agustin58ruiz/DISE-O_CIRCUITOS_ELECTRONICOS_1C_2022/Imagenes/PARTES DEL CIRCUITO.png

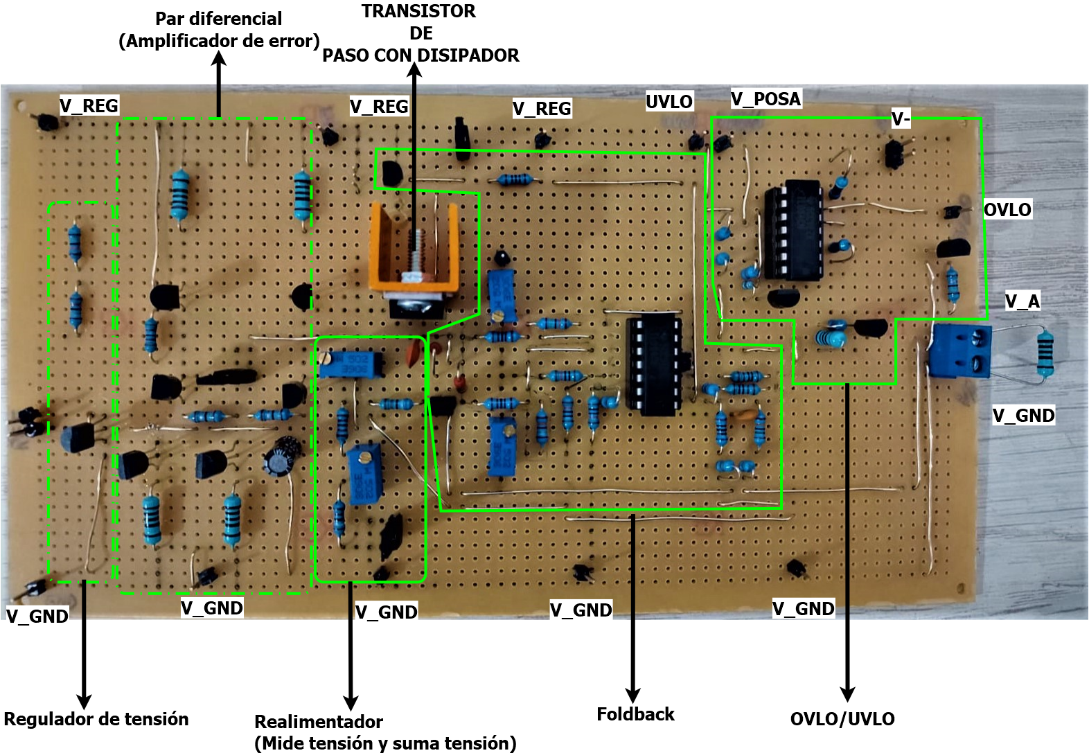
Imagenes/PARTES DEL CIRCUITO.png
