agustin58ruiz/DISE-O_CIRCUITOS_ELECTRONICOS_1C_2022/Eficiencia.png

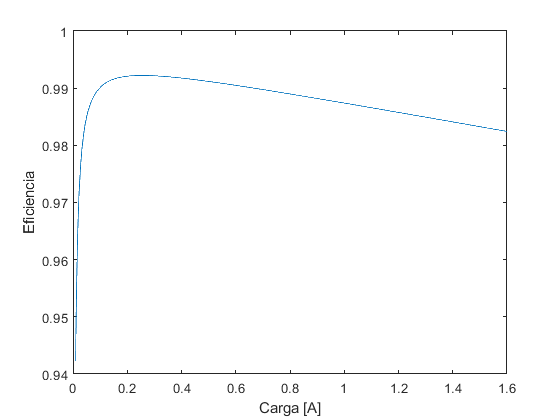
Eficiencia.png
