agustin58ruiz/DISE-O_CIRCUITOS_ELECTRONICOS_1C_2022/reg_de_linea_10us_buck.PNG

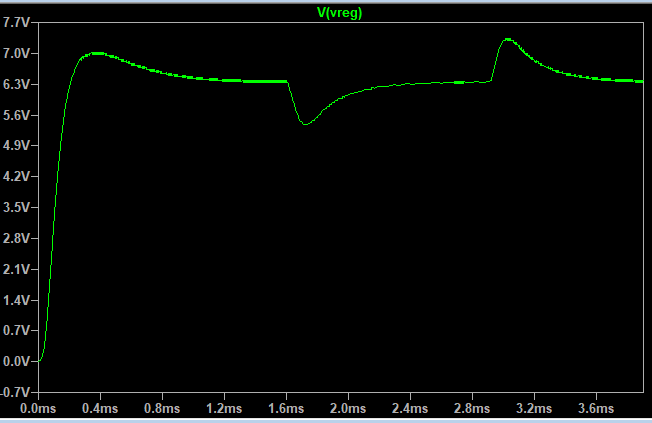
reg_de_linea_10us_buck.PNG
