agustin58ruiz/DISE-O_CIRCUITOS_ELECTRONICOS_1C_2022/resp_en_frec_buck.PNG

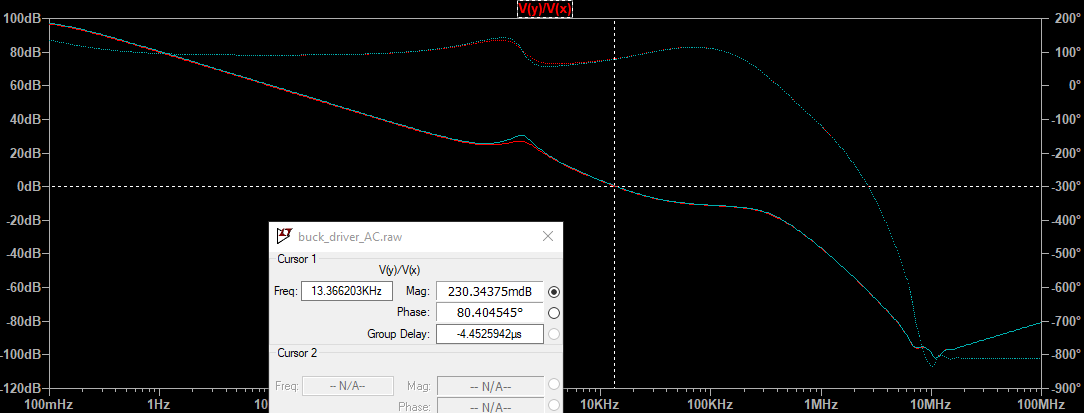
resp_en_frec_buck.PNG
