agustin58ruiz/DISE-O_CIRCUITOS_ELECTRONICOS_1C_2022/BUCK_tran_carga_dinamica.asc

A1: varistor; 60
C2: cap; 270n
C3: cap; .15µ; IC=0
R1: res; 63.5
R2: res; 1µ
R3: res; 1k
R4: res; 3.25
U2: LT1215
V1: voltage; 7; Rser=100m
V2: voltage; -5; Rser=100m
V3: voltage; 36
V4: voltage; PULSE(0 0 1.6m 10u 10u 1.3m)
V6: voltage; 12
V7: voltage; 1.2; Rser=1
V9: voltage; PWL(0 0 1.6m 0 1.61m 10 2m 10 2.01m 0 2.4m 0 2.401m 10 3m 10 3.01m 0 4m 0)
X3: buck
Named nets: 0, V-, VDD, VCC, Vin, VREG, Vref
;.step param RLOAD list 3.7 60
Support
Simulación
Parametros
Carga BUCK
.options gmin=1e-10
.options abstol=1e-10
.options reltol=0.0005
.options cshunt=1e-15
.tran 0 4m 0 startup
Ref1
