agustin58ruiz/DISE-O_CIRCUITOS_ELECTRONICOS_1C_2022/BUCK_tran_linea_dinamica_10us.asc

C2: cap; 270n
C3: cap; .15µ; IC=0
R1: res; 3.7
R3: res; 1k
U2: LT1215
V1: voltage; 7; Rser=100m
V2: voltage; -5; Rser=100m
V3: voltage; 36
V4: voltage; PULSE(0 -24 1.6m 10u 10u 1.3m)
V6: voltage; 12
V7: voltage; 1.2; Rser=1
X3: buck
Named nets: 0, V-, VDD, VCC, Vin, VREG, Vref
;.step param RLOAD list 3.7 60
Support
Simulación
Parametros
Carga BUCK
.options gmin=1e-10
.options abstol=1e-10
.options reltol=0.0005
.options cshunt=1e-15
.tran 0 4m 0 startup
Ref1
