agustin58ruiz/DISE-O_CIRCUITOS_ELECTRONICOS_1C_2022/buck.asc

C1: cap; 454p
C2: cap; 1n
C3: cap; 270n
C4: cap; 3.3n
C5: cap; 1n
C6: cap; {C}; Rser=100m
C7: cap; 0.01µ
C8: cap; 120p
C9: cap; 200p
C10: cap; 200p
C11: cap; 1n; Rser=1m
C12: cap; 100p
C13: cap; 10n
C14: cap; 3.3n
C15: cap; 10n
D1: diode; 1N4148
D2: diode; 1N4007
D3: diode; 1N4148
D4: diode; 1N4007
D5: diode; 1N4007
L1: ind; 7.5n
L2: ind; 7.5n
L3: ind; 4.5n
L4: ind; {L}
L5: ind; 4.5n
M1: nmos; NDC7002N
M2: pmos; Si1013
R1: res; 400
R2: res; 10.9k
R3: res; 110k
R4: res; 400
R5: res; 99k
R6: res; 1k
R7: res; 100k
R8: res; 3.3k
R9: res; 120k
R10: res; 10
R11: res; 1
R12: res; 1
R13: res; 10k
R14: res; 42.9k
R15: res; 10
R16: res; 100
R17: res; 100
R18: res; 1k
R19: res; 5k
U1: IR2110
U2: TL081
U3: TL081
U4: irf520
U5: NE555
U6: irf520
U7: LT1215
U8: LT1720
X1: NAND
X2: NAND
X5: NOT
X7: NOT
X8: NOT
X9: NOT
Named nets: HO2, LO2, HIN, LIN, Vsaw, Vcua, V-, Vref, GND, VDD, VCC, Vin, VREG, Verr
.param C 100u
.param L 65.3u
.include irf520.txt
.include IR2110.txt
.MODEL 1N4007 D  ( IS=76.9p RS=42.0m BV=1.00k IBV=5.00u
+ CJO=26.5p  M=0.333 N=1.45 TT=4.32u )
Generacion del diente de sierra
Comparador con diente de sierra
Driver
Error amp
f
Puertos
Generador de dead-time
Parametros
Modelos
Librerías
