agustin58ruiz/DISE-O_CIRCUITOS_ELECTRONICOS_1C_2022/uvlo_problematico.asc

M1: nmos; 2N7000
R1: res; 120k
R2: res; 30k
R3: res; 750k
UVLO1: LT1721
V1: voltage; 1.2
V2: voltage; 5
V3: voltage; PWL(0 0 0.2m 8 0.3m 5.63 1m 5.93)
V4: voltage; SINE(0 20m 200k)
Named nets: 0, Vdd, Vref2, Vo, uvlo, vdd
UVLO
Fall: 5.6V
Rise: 5.9V
.tran 0 1m 0
.model 2N7000 VDMOS(Rg=3 Vto=3 Rd=0 Rs=.75 Rb=.14 Kp=.17 mtriode=1.25 Cgdmax=80p Cgdmin=12p Cgs=50p Cjo=50p Is=.04p mfg=Fairchild Vds=60 Ron=5 Qg=.223n)
