agustin58ruiz/DISE-O_CIRCUITOS_ELECTRONICOS_1C_2022/buck_driver_lazo_abierto.asc

A1: srflop; 15
C1: cap; {Csnub}
C2: cap; {Csnub}
C3: cap; 270n
C4: cap; 270n
C5: cap; 3.3n
C6: cap; {CLOAD}; Rser=100m
C7: cap; 3.3n
C8: cap; 10n
C11: cap; 1n; Rser=1m
CurrMax1: LT1721
D1: diode; 1N4007
D2: diode; 1N4007
D3: diode; 1N4007
E1: e; 15
E2: e; 15
L1: ind; 7.5n
L2: ind; 4.5n
L3: ind; 7.5n
L4: ind; {L}
L5: ind; 4.5n
M2: nmos; 2N7000
OVLO1: LT1721
R1: res; 10
R2: res; 10
R3: res; 120k
R4: res; 4.99k
R5: res; 1k
R6: res; 30k
R7: res; 250
R8: res; 750k
R9: res; 60k
R10: res; {RLOAD}
R11: res; 1
R12: res; 1
R13: res; 60k
R14: res; 10k
R15: res; 10k
Rsens1: res; 0.1
U1: IR2110
U2: LT1215
U3: irf520
U6: irf520
UVLO1: LT1721
V1: voltage; 7
V2: voltage; PULSE(7 0 0 1n 1n 0.8939u 5u)
V3: voltage; PULSE(0 7 10n 1n 1n 0.8699u 5u)
V4: voltage; PWL(1n 0 20u 36 120u 46 150u 24)
V5: voltage; 5
V6: voltage; 1.2
V13: voltage; 15
X1: OR
Named nets: 0, LO2, HO2, HIN, LIN, V+, VO, VS, Vdd, Vref, Vo, uvlo, ovlo, OCP, sens+, sens-, Q, Qnot
.tran 0 150u 0 startup
.param CLOAD 1u
.param RLOAD=6
.param L 65.3u
.include irf520.txt
.include IR2110.txt
.MODEL 1N4007 D  ( IS=76.9p RS=42.0m BV=1.00k IBV=5.00u
+ CJO=26.5p  M=0.333 N=1.45 TT=4.32u )
.options gmin=1e-10
.options abstol=1e-10
.options reltol=0.0005
.options cshunt=1e-15
Driver
.param Csnub 10n
OVLO
Rise: 7.2V
UVLO
Fall: 5.6V
Rise: 5.9V
f = IoMax / Vref
A = f / Rsens
OCP
.model 2N7000 VDMOS(Rg=3 Vto=3 Rd=0 Rs=.75 Rb=.14 Kp=.17 mtriode=1.25 Cgdmax=80p Cgdmin=12p Cgs=50p Cjo=50p Is=.04p mfg=Fairchild Vds=60 Ron=5 Qg=.223n)
trig: 2A
Latch
