agustin58ruiz/DISE-O_CIRCUITOS_ELECTRONICOS_1C_2022/buck_driver_AC.asc

B2: bv; V=delay(v(ctrl)/5.75, 190ns)
C1: cap; 100p
C2: cap; 1n
C3: cap; 1n; Rser=5m
C5: cap; 1n
C6: cap; {CLOAD}; Rser=100m
L4: ind; {L}
R1: res; 100
R2: res; 1k
R3: res; 5k
R7: res; 100k
R8: res; 10k
R9: res; 100k
R10: res; {RLOAD}
R13: res; 10k
R14: res; 42.9k
U1: ccm2; Ron=0.23
U2: TL081
U3: TL081
V1: voltage; PULSE(0 -24 1m 10u 10u 1m)
V2: voltage; 1.2
V10: voltage; 36
Vg1: voltage; 7; AC 1
Vg2: voltage; 5; AC 1
Vz1: voltage; ""; AC 1
Named nets: 0, VO, VPOS, Verr, ctrl, x, y, VPOS-
;tran 0 3m 0 startup
.param CLOAD 100u
.step param RLOAD list 3.7 61
.param L 65.3u
.include irf520.txt
.include IR2110.txt
.MODEL 1N4007 D  ( IS=76.9p RS=42.0m BV=1.00k IBV=5.00u
+ CJO=26.5p  M=0.333 N=1.45 TT=4.32u )
.options gmin=1e-10
.options abstol=1e-10
.options reltol=0.003
.options cshunt=1e-15
Error amp
f
.include average.lib
.ac dec 100 .1 100meg
