agustin58ruiz/DISE-O_CIRCUITOS_ELECTRONICOS_1C_2022/dead_time.asc

C1: cap; 200p
C2: cap; 200p
M1: nmos; NDC7002N
M2: pmos; Si1013
V1: voltage; PULSE(0 7 0 80n 80n 0.8u 5u)
Vg1: voltage; 7; AC 1; Rser=100m
X1: NAND
X2: NAND
X5: NOT
X6: NOT
X7: NOT
X8: NOT
Named nets: VPOS, 0, LIN, HIN
Inversor
.tran 0 1m 0
