agustin58ruiz/DISE-O_CIRCUITOS_ELECTRONICOS_1C_2022/BUCK_LDO_tran.asc

C1: cap; {CLOAD}
C2: cap; 270n
C3: cap; {CLOAD}
R1: res; 3.6k
R2: res; 5k
R3: res; 5k
R4: res; R=v(VAR)
R17: res; R=v(VAR)
R18: res; 10
SEL1: voltage; PWL(500m 5 501m 0 1 0)
U1: LT1009
V1: voltage; 7
V2: voltage; -5
V3: voltage; PWL(25m 5 75m 250 250m 250 270m 0.01 350m 0.01 400m 15 475m 15 500m 5 525m 5 575m 250 750m 250 770m 0.01 850m 0.01 900m 15 975m 15 1 5)
V4: voltage; PWL(125m 5 126m 0 150m 0 175m 5 625m 5 626m 0 650m 0 675m 5)
V5: voltage; 5
V6: voltage; 15
V7: voltage; 36
Vref1: voltage; 1.2
X1: LDOA
X2: LDOB
X3: buck
Named nets: 0, V-, VAR, VREG, S, E, Vposa, Vref, VDD, VCC, Vin
.op
.param CLOAD 15u
.tran 0 1 0 .00005
Enable
Carga
Carga LDOB
Ref1
Ref2
Support
Simulación
Parametros
Selección usuario
Carga
Carga LDOA
