agustin58ruiz/DISE-O_CIRCUITOS_ELECTRONICOS_1C_2022/LDOA_foldback.asc

C1: cap; 100n
C2: cap; {CLOAD}
C4: cap; 22n
M1: pmos; BS250P
M3: nmos; 2N7000
Q1: npn; BC547C
Q2: npn; BC547C
Q3: npn; BC547C
Q4: npn; BC547C
Q5: pnp; BC557C
Q6: pnp; BC557C
R1: res; 11k
R2: res; 100
R3: res; 11k
R4: res; 5.36k
R5: res; 100
R6: res; 10
R7: res; 243k
R8: res; 100
R10: res; 100
R11: res; 24.9
R12: res; 49.9
R19: res; 665
R20: res; 2.21k
R21: res; 1.82k
R28: res; 6.98k
R29: res; 243k
R30: res; 4.02k
R31: res; 6.98k
R32: res; 100k
R33: res; 100k
R34: res; 100k
R35: res; 100k
R36: res; 1k
R37: res; 1k
R38: res; 150k
R39: res; 150k
RL: res; {RLOAD}
Rs1: res; .1
SEL1: voltage; 5
U1: irf9520
U2: TL081
U3: TL081
U5: TL081
V1: voltage; 0
V2: voltage; -5
Vref: voltage; 1.2
VREG: voltage; 6.35
Named nets: 0, Va, Vref, Vo, Vi, va, VREG, Vact, Vs, Vsens, Vref2, Vf, V-
Referencia
Realimentador
a
Transistor de paso
Carga
.step param RLOAD .01 15 .04
.op
Buck
.inc sihf9520.txt
.model 2N7000 VDMOS(Rg=3 Vto=3 Rd=0 Rs=.75 Rb=.14 Kp=.17 mtriode=1.25 Cgdmax=80p Cgdmin=12p Cgs=50p Cjo=50p Is=.04p mfg=Fairchild Vds=60 Ron=5 Qg=.223n)
Actuador
Amplificador de Error
.param CLOAD 15u
Sumador
Sensado de Corriente
.MODEL BS250P VDMOS pchan Rg=160 VTO=-3.193 RS=2.041 RD=0.697 IS=2E-13 KP=0.277 Cjo=105p LAMBDA=1.2E-2 RB=0.309 Rds=1.2E8 Cgdmax=57p Cgdmin=5p CGS=47p TT=86.56n BV=45 IBV=10u
