agustin58ruiz/DISE-O_CIRCUITOS_ELECTRONICOS_1C_2022/LDOA_mc.asc

C1: cap; {mc(100n,tolc)}
C2: cap; {mc(22n,tolc)}
C3: cap; {CLOAD}
M1: pmos; BS250P
M2: nmos; 2N7000
M3: pmos; BS250P
M4: nmos; 2N7000
M5: nmos; 2N7000
M6: pmos; BS250P
Q1: npn; BC547C
Q2: npn; BC547C
Q3: npn; BC547C
Q4: npn; BC547C
Q5: pnp; BC557C
Q6: pnp; BC557C
R1: res; {mc(665,tolr)}
R2: res; {mc(2.21k,tolr)}
R3: res; {mc(1.82k,tolr)}
R4: res; {mc(6.98k,tolr)}
R5: res; {mc(11k,tolr)}
R6: res; {mc(11k,tolr)}
R7: res; {mc(243k,tolr)}
R8: res; {mc(243k,tolr)}
R9: res; {mc(4.02k,tolr)}
R10: res; {mc(6.98k,tolr)}
R11: res; {mc(100k,tolr)}
R12: res; {mc(100k,tolr)}
R13: res; {mc(100k,tolr)}
R14: res; {mc(100k,tolr)}
R15: res; {mc(1k,tolr)}
R16: res; {mc(1k,tolr)}
R17: res; {mc(150k,tolr)}
R18: res; {mc(150k,tolr)}
R19: res; {mc(100,tolr)}
R20: res; {mc(5.36k,tolr)}
R21: res; {mc(100,tolr)}
R22: res; {mc(100,tolr)}
R23: res; {mc(100,tolr)}
R24: res; {mc(24.9,tolr)}
R25: res; {mc(24.9,tolr)}
R26: res; {mc(40.2k,tolr)}
R27: res; {mc(250k,tolr)}
R28: res; {mc(60.4k,tolr)}
R29: res; {mc(9.76k,tolr)}
R30: res; {mc(9.09k,tolr)}
R31: res; {mc(0.715k,tolr)}
R32: res; 10
R33: res; 3.6k
R34: res; 5k
R35: res; 5k
R36: res; 25.5
RLOAD: res; R=v(VAR)
Rs1: res; {mc(.1,tolr)}
SEL1: voltage; PWL(500m 5 501m 0 1 0)
U1: irf9520
U2: TL081
U3: TL081
U4: TL081
U5: TL081
U6: TL081
U7: LT1009
V1: voltage; -6.35
V2: voltage; PWL(125m 5 126m 0 150m 0 175m 5 625m 5 626m 0 650m 0 675m 5)
V3: voltage; 5
V4: voltage; PWL(25m 7 75m 250 250m 250 320m 0.01 350m 0.01 400m 7 401m 7 401.000000001m 1G 402m 1G 403m 15 475m 15 500m 10 525m 10 575m 250 600m 250 700m 250 701m 10 702m 10 703m 1G 704m 250 710m 250 900m 0.01 925m 0.01 950m 15 975m 15 1 10 702.000001 1G)
Vref1: voltage; 1.2
VREG1: voltage; PULSE(0 6.35 .00001 .00001 .00001 1)
Named nets: VREG, Vact, Vsens, Vref2, Vref, Vf, 0, V-, ENLDOA, VA, SELA, GND, VPOSA, Vposa, UVLO_OUT, OVLO_OUT, VAR, S, ovlo, uvlo
.param RLOAD 100
.inc sihf9520.txt
.model 2N7000 VDMOS(Rg=3 Vto=3 Rd=0 Rs=.75 Rb=.14 Kp=.17 mtriode=1.25 Cgdmax=80p Cgdmin=12p Cgs=50p Cjo=50p Is=.04p mfg=Fairchild Vds=60 Ron=5 Qg=.223n)
.param CLOAD 15u
Referencias
Amplificador de error
Enable
Actuador
Transistor
de paso
Realimentador
Sensado de corriente
Sumador
Amplificador
de error
Modelos
Parámetros
Librerías
Foldback
Foldback
UVLO
OVLO
Mediciones MC
.step param x 0 999 1 ; a dummy parameter to cycle Monte Carlo Runs
.meas TRAN Tensión5V AVG V(VA) FROM 30m TO 35m
.param tolr=0.01 ;+/-1% tolerancia de la resistencia
.param tolc=0.2 ;+/-20% tolerancia del capacitor
Tolerancias MC
Simulación
.option noopiter
.tran 0 1 0 .00005
Enable
Ref1
Ref2
Support
Buck
Carga
Carga
Selección usuario
.meas TRAN Tensión3.3V AVG V(VA) FROM 530m TO 535m
.meas TRAN CorrienteFoldback AVG I(RLOAD) FROM 325m TO 340m
.meas TRAN CorrienteMax MAX I(RLOAD) FROM 318m TO 319m
.meas TRAN StartupTime FIND time WHEN V(va)=4.9
.MODEL BS250P VDMOS pchan Rg=160 VTO=-3.193 RS=2.041 RD=0.697 IS=2E-13 KP=0.277 Cjo=105p LAMBDA=1.2E-2 RB=0.309 Rds=1.2E8 Cgdmax=57p Cgdmin=5p CGS=47p TT=86.56n BV=45 IBV=10u
.meas TRAN VA_UVLO_5V(rising) AVG V(uvlo) from 905m to 918m
.meas TRAN VA_UVLO_3V(rising) AVG V(uvlo) from 72m to 96m
.meas TRAN VA_UVLO_3V(falling) AVG (V(uvlo)*V(va)/V(vf)) from 40ms to 50ms
.meas TRAN F5 AVG (V(va)/V(vf)) from 800ms to 810ms
.meas TRAN F3 AVG (V(va)/V(vf)) from 40ms to 50ms
.meas TRAN VA_UVLO_5V(falling) AVG (V(uvlo)*V(va)/V(vf)) from 800ms to 810ms
.meas TRAN VA_OVLO_3V(rising) AVG (V(ovlo)*V(va)/V(vf)) from 701.6ms to 701.8ms
.meas TRAN VA_OVLO_3V(falling) AVG (V(ovlo)*V(va)/V(vf)) from 702.4ms to 703.6ms
.meas TRAN VA_OVLO_5V(rising) AVG (V(ovlo)*V(va)/V(vf)) from 380ms to 400ms
.meas TRAN VA_OVLO_5V(falling) AVG (V(ovlo)*V(va)/V(vf)) from 401.4ms to 402.6ms
