agustin58ruiz/DISE-O_CIRCUITOS_ELECTRONICOS_1C_2022/LDOA_with_OVLO.asc

C1: cap; 100n
C4: cap; 22n
M1: pmos; FDC5614P
M2: pmos; FDC5614P
M3: nmos; 2N7000
M4: nmos; 2N7000
M5: nmos; BSP89
M6: nmos; 2N7000
Q1: npn; BC547C
Q2: npn; BC547C
Q3: npn; BC547C
Q4: npn; BC547C
Q5: pnp; BC557C
Q6: pnp; BC557C
R1: res; 11k
R2: res; 100
R3: res; 11k
R4: res; 5.36k
R5: res; 100
R6: res; 70k
R7: res; 243k
R8: res; 100
R9: res; 50k
R10: res; 100
R11: res; 24.9
R12: res; 49.9
R19: res; 665
R20: res; 2.21k
R21: res; 1.82k
R28: res; 6.98k
R29: res; 243k
R30: res; 4.02k
R31: res; 6.98k
R32: res; 100k
R33: res; 100k
R34: res; 100k
R35: res; 100k
R36: res; 1k
R37: res; 1k
R38: res; 150k
R39: res; 150k
RB1: res; 1.13k
RB: res; 4.99k
RH1: res; 25k
RH: res; 4.99k
Rs1: res; .1
RT1: res; 1k
RT: res; 10k
U1: irf9520
U2: TL081
U3: TL081
U4: OP07
U5: TL081
U6: OP07
Named nets: VREG, Vact, Vs, Vsens, Vref2, Vref, Vf, 0, V-, ENLDOA, VA, SELA, GND, VPOSA, Vposa, V_OVLO, V_OVLO_ACT, V_UVLO, V_UVLO_ACT, Vref_XVLO
Referencia
Realimentador
a
Transistor de paso
Carga
.param RLOAD 100
.inc sihf9520.txt
.model 2N7000 VDMOS(Rg=3 Vto=3 Rd=0 Rs=.75 Rb=.14 Kp=.17 mtriode=1.25 Cgdmax=80p Cgdmin=12p Cgs=50p Cjo=50p Is=.04p mfg=Fairchild Vds=60 Ron=5 Qg=.223n)
Actuador
Amplificador de Error
.param CLOAD 15u
Sumador
Sensado de Corriente
Enable
