agustin58ruiz/DISE-O_CIRCUITOS_ELECTRONICOS_1C_2022/LDOB_compensadoV.asc

C1: cap; 10Meg
C2: cap; {CLOAD}
C3: cap; 100n
L1: ind; 10Meg
M1: nmos; 2N7000
Q1: pnp; BC557C
Q2: pnp; BC557C
Q7: npn; BC547C
Q8: npn; BC547C
Q9: npn; BC547C
Q10: npn; BC547C
R1: res; 24.9
R2: res; 2.21k
R3: res; 49.9
R4: res; 1.82k
R5: res; 6.98k
R6: res; 10
R9: res; 100
R10: res; 5.36k
R11: res; 100
R13: res; 100
R14: res; 100
RL: res; {RLOAD}
SEL1: voltage; 5
U1: irf9520
V1: voltage; 0
V2: voltage; 1.2; AC 1
Vref: voltage; 1.2
VREG: voltage; 6.35
Named nets: 0, Va, Vref, Vo, Vf, Vi, VREG, Vs, va
Referencia
a
Transistor de paso
Carga
;.step param RLOAD .01 15 .04
;.op
Buck
.inc sihf9520.txt
.model 2N7000 VDMOS(Rg=3 Vto=3 Rd=0 Rs=.75 Rb=.14 Kp=.17 mtriode=1.25 Cgdmax=80p Cgdmin=12p Cgs=50p Cjo=50p Is=.04p mfg=Fairchild Vds=60 Ron=5 Qg=.223n)
.lib opamp.sub
.ac dec 100 .01 100Meg
;.step param RLOAD 5 250 245
;.step param CLOAD 1u 15u 14u
.param CLOAD 15u
.param RLOAD 250
.op
Realimentador
