agustin58ruiz/DISE-O_CIRCUITOS_ELECTRONICOS_1C_2022/LDOB_wc.asc

C1: cap; {wcc(100n,tolc,10)}
C2: cap; 22n
C3: cap; {CLOAD}
M1: pmos; FDC5614P
M2: nmos; 2N7000
M3: pmos; FDC5614P
M4: nmos; AON6560
M5: nmos; AON6560
Q1: npn; BC547C
Q2: npn; BC547C
Q3: npn; BC547C
Q4: npn; BC547C
Q5: pnp; BC557C
Q6: pnp; BC557C
R1: res; 665
R2: res; {wc(2.21k,tolr,7)}
R3: res; {wc(1.82k,tolr,6)}
R4: res; {wc(6.98k,tolr,8)}
R5: res; 11k
R6: res; 11k
R7: res; 121k
R8: res; 121k
R9: res; 4.02k
R10: res; 6.98k
R11: res; 100k
R12: res; 100k
R13: res; 100k
R14: res; 100k
R15: res; 1k
R16: res; 1k
R17: res; 150n
R18: res; 150k
R19: res; {wc(100,tolr,4)}
R20: res; {wc(5.36k,tolr,11)}
R21: res; {wc(100,tolr,0)}
R22: res; {wc(100,tolr,1)}
R23: res; {wc(100,tolr,5)}
R24: res; {wc(24.9,tolr,3)}
R25: res; {wc(24.9,tolr,2)}
R26: res; 36k
R27: res; 250k
R28: res; 64k
R29: res; 10k
R30: res; 10k
R31: res; 1k
R32: res; 10
R33: res; 3.6k
R34: res; 5k
R35: res; 5k
R36: res; 5
Rs1: res; {wc(.1,tolr,9)}
SEL1: voltage; PWL(500m 5 501m 0 1 0)
U1: irf9520
U2: TL081
U3: TL081
U4: TL081
U5: TL081
U6: TL081
U7: LT1009
V1: voltage; -5
V2: voltage; 5
V3: voltage; 5
Vref1: voltage; 1.2
VREG1: voltage; PULSE(0 6.35 .00001 .00001 .00001 1)
Named nets: VREG, Vact, Vsens, Vref2, Vref, Vf, 0, V-, ENLDOB, VB, SELB, GND, VPOSA, Vposa, UVLO_OUT, OVLO_OUT, S
.param RLOAD 100
.inc sihf9520.txt
.model 2N7000 VDMOS(Rg=3 Vto=3 Rd=0 Rs=.75 Rb=.14 Kp=.17 mtriode=1.25 Cgdmax=80p Cgdmin=12p Cgs=50p Cjo=50p Is=.04p mfg=Fairchild Vds=60 Ron=5 Qg=.223n)
.param CLOAD 15u
Referencias
Amplificador de error
Enable
Actuador
Transistor
de paso
Realimentador
Sensado de corriente
Sumador
Amplificador
de error
Modelos
Parámetros
Librerías
Foldback
Foldback
UVLO
OVLO
Mediciones MC
.meas TRAN Tensión5V AVG V(VB) FROM 30m TO 35m
.param tolr=0.01 ;+/-1% tolerancia de la resistencia
.param tolc=0.2 ;+/-20% tolerancia del capacitor
Tolerancias MC
Simulación
.option noopiter
.tran 0 1 0 .00005
Enable
Ref1
Ref2
Support
Buck
Carga
Carga
Selección usuario
.meas TRAN Tensión3.3V AVG V(VB) FROM 530m TO 535m
Tenemos N = 10 --> 2^N + 1 = 2049 índices
.func wcc(nom,tolc,index) if(run==numruns,nom,if(binary(run,index),nom*(1+tolc),nom*(1-tolc)))
.func binary(run,index) floor(run/(2**index))-2*floor(run/(2**(index+1)))
.func wc(nom,tolr,index) if(run==numruns,nom,if(binary(run,index),nom*(1+tolr),nom*(1-tolr)))
Worst Case simulation and parameters
.step param run 0 2049 1
.param numruns=2049
