agustin58ruiz/DISE-O_CIRCUITOS_ELECTRONICOS_1C_2022/LDOB_wc2.asc

C1: cap; {wcc(100n,tolr,0)}
C2: cap; 22n
C3: cap; 2.2µ
M1: pmos; BS250P
M2: nmos; 2N7000
M3: pmos; BS250P
M4: nmos; 2N7000
M5: nmos; 2N7000
M6: pmos; BS250P
Q1: npn; BC547C
Q2: npn; BC547C
Q3: npn; BC547C
Q4: npn; BC547C
Q5: pnp; BC557C
Q6: pnp; BC557C
R1: res; 665
R2: res; {wc(2.21k,tolr,8)}
R3: res; {wc(1.82k,tolr,1)}
R4: res; {wc(6.98k,tolr,7)}
R5: res; 11k
R6: res; 11k
R7: res; 243k
R8: res; 243k
R9: res; 4.02k
R10: res; 6.98k
R11: res; 100k
R12: res; 100k
R13: res; 100k
R14: res; 100k
R15: res; 1k
R16: res; 1k
R17: res; 150k
R18: res; 150k
R19: res; 100
R20: res; {wc(5.36k,tolr,2)}
R21: res; {wc(100,tolr,5)}
R22: res; {wc(100,tolr,6)}
R23: res; 100
R24: res; {wc(24.9,tolr,4)}
R25: res; {wc(24.9,tolr,3)}
R26: res; 36k
R27: res; 250k
R28: res; 64k
R29: res; 9k
R30: res; 10k
R31: res; 1k
R32: res; 10
R33: res; 3.6k
R34: res; 5k
R35: res; 5k
R36: res; 25.5
RLOAD: res; 50
Rs1: res; .1
SEL1: voltage; PWL(500m 0 501m 0 1 0)
U1: irf9520
U2: TL081
U3: TL081
U4: TL081
U5: TL081
U6: TL081
U7: LT1009
V1: voltage; -5
V2: voltage; 5
V3: voltage; 5
V4: voltage; PWL(5m 10 10.9m 10 11m 6.6 12m 6.6 15m 0.01 320m 0.01 350m 0.01 400m 7 401m 7 401.000000001m 1G 402m 1G 403m 15 475m 15 500m 5 525m 5 575m 250 600m 250 700m 250 701m 5 702m 5 703m 1G 704m 250 710m 250 820m 0.01 850m 0.01 900m 15 975m 15 1 5 702.000001 1G)
Vref1: voltage; 1.2
VREG1: voltage; PULSE(0 6.35 .00001 .00001 .00001 1)
Named nets: VREG, Vact, Vsens, Vref2, Vref, Vf, 0, V-, ENLDOB, VB, SELB, GND, VPOSA, Vposa, UVLO_OUT, OVLO_OUT, VAR, S, ovlo, uvlo
.param RLOAD 100
.inc sihf9520.txt
.model 2N7000 VDMOS(Rg=3 Vto=3 Rd=0 Rs=.75 Rb=.14 Kp=.17 mtriode=1.25 Cgdmax=80p Cgdmin=12p Cgs=50p Cjo=50p Is=.04p mfg=Fairchild Vds=60 Ron=5 Qg=.223n)
.param CLOAD 15u
Referencias
Amplificador de error
Enable
Actuador
Transistor
de paso
Realimentador
Sensado de corriente
Sumador
Amplificador
de error
Modelos
Parámetros
Librerías
Foldback
Foldback
UVLO
OVLO
Mediciones MC
.param tolr=0.01 ;+/-1% tolerancia de la resistencia
.param tolc=0.2 ;+/-20% tolerancia del capacitor
Tolerancias MC
Simulación
.option noopiter
.tran 0 2m 0 .00005
Enable
Ref1
Ref2
Support
Buck
Carga
Carga
Selección usuario
.MODEL BS250P VDMOS pchan Rg=160 VTO=-3.193 RS=2.041 RD=0.697 IS=2E-13 KP=0.277 Cjo=105p LAMBDA=1.2E-2 RB=0.309 Rds=1.2E8 Cgdmax=57p Cgdmin=5p CGS=47p TT=86.56n BV=45 IBV=10u
Tenemos N = 8 --> 3^N + 1 = 257 índices
.func wcc(nom,tolc,index) if(run==numruns,nom,if(binary(run,index),nom*(1+tolc),nom*(1-tolc)))
.func binary(run,index) floor(run/(2**index))-2*floor(run/(2**(index+1)))
.func wc(nom,tolr,index) if(run==numruns,nom,if(binary(run,index),nom*(1+tolr),nom*(1-tolr)))
Worst Case simulation and parameters
.step param run 0 257 1
.param numruns=257
