agustin58ruiz/DISE-O_CIRCUITOS_ELECTRONICOS_1C_2022/buck_ideal.asc

C6: cap; {CLOAD}
L4: ind; {L}
R10: res; {RLOAD}
R11: res; 1
R12: res; 1
U3: irf520
U6: irf520
V1: voltage; PULSE(0 7 0 1n 1n 0.8798u 5u)
V2: voltage; PULSE(0 7 0.882u 1n 1n 4.1198u 5u)
V10: voltage; 36
Named nets: 0, VO
.tran 0 2m 0 startup
.param CLOAD 1u
.param RLOAD 3.7
.param L 65.3u
.include irf520.txt
.include IR2110.txt
.MODEL 1N4007 D  ( IS=76.9p RS=42.0m BV=1.00k IBV=5.00u
+ CJO=26.5p  M=0.333 N=1.45 TT=4.32u )
.options gmin=1e-10
.options abstol=1e-10
.options reltol=0.0005
.options cshunt=1e-15
.lib switching.lib
