agustin58ruiz/DISE-O_CIRCUITOS_ELECTRONICOS_1C_2022/buck_driver.asc

C1: cap; 454p
C2: cap; 3.9nF
C3: cap; 270n
C4: cap; 270n
C5: cap; 13nF
C6: cap; {CLOAD}
C7: cap; 0.01µ
C8: cap; 45.4p
D2: diode; 1N4007
L4: ind; {L}
M1: nmos; NDC7002N
M2: pmos; Si1013
R1: res; 500
R2: res; 10.5k
R3: res; 110k
R4: res; 500
R5: res; 99k
R6: res; 1k
R7: res; 8.6k
R8: res; 360
R9: res; 30k
R10: res; {RLOAD}
R11: res; 1
R12: res; 1
R13: res; 10k
R14: res; 42.9k
R15: res; 100k
R16: res; 100k
U1: IR2110
U2: LT1215
U3: irf520
U4: LT1215
U5: NE555
U6: irf520
U7: LT1215
U8: LT1215
V1: voltage; 7
V2: voltage; 1.2
V10: voltage; 36
V13: voltage; 15
Vg1: voltage; 12; AC 1
Named nets: 0, HO2, LO2, HIN, LIN, V+, VO, VPOS, Verr, Vsaw, Vcua
.tran 0 5m 0 startup
.param CLOAD 15u
.param RLOAD 3
.param L 15u
.include irf520.txt
.include IR2110.txt
.MODEL 1N4007 D  ( IS=76.9p RS=42.0m BV=1.00k IBV=5.00u
+ CJO=26.5p  M=0.333 N=1.45 TT=4.32u )
.options gmin=1e-10
.options abstol=1e-10
.options reltol=0.003
.options cshunt=1e-15
Generacion del diente de sierra
Comparador con diente de sierra
Driver
Inversor
Error amp
f
