agustin58ruiz/DISE-O_CIRCUITOS_ELECTRONICOS_1C_2022/support.asc

Bat: voltage; 36v
Buck: voltage; 6.35
C1: cap; 22µ
C2: cap; 33µ
C3: cap; 0.022µ
C4: cap; 0.01µ
D1: diode; 1N4007
D2: diode; 1N4007
R2: res; 3.6k
R3: res; 5k
R4: res; 5k
R5: res; 10k
R6: res; 1k
U1: LT1009
U2: NE555
V2: voltage; 5
Vref1: voltage; 1.2
Named nets: 0, E, Vposa, Vref, V-, Vin, Vreg
Enable
Ref2
.MODEL 1N4007 D  ( IS=76.9p RS=42.0m BV=1.00k IBV=5.00u
+ CJO=26.5p  M=0.333 N=1.45 TT=4.32u )
V- = -5V
Ref2 = 2.5V
Enable = 0V vs 5V
Ref1 = 1.2V
.tran 100m
Bateria
Externo
