agustin58ruiz/DISE-O_CIRCUITOS_ELECTRONICOS_1C_2022/buck_controlador_uc3842.asc

C1: cap; 100p
C2: cap; 1n
C3: cap; 0.0022µ
C5: cap; 0.01µ
C7: cap; {CLOAD}
L1: ind; {L}
R1: res; 150k
R2: res; 10k
R4: res; 75m
R5: res; 10k
R7: res; 10k
R8: res; 37k
R10: res; 1k
R15: res; {RLOAD}
U1: UC3842
U2: irf520
U4: irf520
V2: voltage; 20
V5: voltage; 36
V6: voltage; PULSE(0 6 5n .1n .1n 0.872u 5u)
V7: voltage; PULSE(6 0 0 .1n .1n 0.882u 5u)
Named nets: 0, Vsens
.tran 0 5m 0 1u startup
.include irf520.txt
.include uc3842.txt
fT(kHz)=           1.72
_____________
RT(kOhm)*CT(uF)
.param CLOAD 1u
.param RLOAD 300
.param L 15u
