agustin58ruiz/DISE-O_CIRCUITOS_ELECTRONICOS_1C_2022/buck_controlador_uc3846.asc

C1: cap; 0.00087µ
C2: cap; .1µ
C3: cap; 1n
C4: cap; .1µ
C5: cap; 220n
C6: cap; 220n
C7: cap; {CLOAD}
C11: cap; 0.0015µ
D1: diode
L1: ind; {L}
Q1: npn; 2N2222
R1: res; 400
R2: res; 3k
R3: res; 5.6k
R4: res; .1
R5: res; 8k
R6: res; 990
R7: res; 10k
R8: res; 40.8k
R9: res; 10
R10: res; 1k
R11: res; 1
R12: res; 1
R13: res; 1
R14: res; 1
R15: res; {RLOAD}
R16: res; 10
R17: res; 10
R20: res; 68k
R21: res; 10k
S1: sw; MYSW
S2: sw; MYSW
S3: sw; MYSW
S4: sw; MYSW
U2: irf520
U3: SG1846
U4: irf520
V3: voltage; 15
V5: voltage; 36
VDRV1: voltage; 10
X1: NOT
Named nets: 0, Vsens, VO, REF, HIN, LIN, HO, LO, Vcc, Vs, Vb
.tran 0 1m .4m .2u startup
.include irf520.txt
fT(kHz)=           2.2
_____________
RT(kOhm)*CT(uF)
.param CLOAD 10u
.param RLOAD 3
.param L 15u
.include SG1846.txt
.model MYSW SW(Ron=.01 Roff=1Meg Vt=5 Vh=0)
