agustin58ruiz/DISE-O_CIRCUITOS_ELECTRONICOS_1C_2022/buck_pwm.asc

B1: bv; V=limit(v(ctrl), 0.01, 0.9)
C1: cap; 220n
C8: cap; {CLOAD}
C9: cap; 3.9nF
C10: cap; 13nF
C11: cap; 220n
D2: diode
L4: ind; {L}
R19: res; 8.6k
R20: res; 360
R21: res; 30k
R22: res; {RLOAD}
R23: res; 1
R24: res; 1
R25: res; 1
R26: res; 1
R27: res; 1
R28: res; 1
R31: res; 10k
R32: res; 40.8k
S7: sw; MYSW
S8: sw; MYSW
S9: sw; MYSW
S10: sw; MYSW
U8: PWM; VM=1V, fs=200kHz
U9: LT1215
U10: irf520
U11: irf520
V13: voltage; PULSE(0 36 .3m 1n 1n 1)
V14: voltage; PULSE(0 -24 1.5m 10u 1n 1)
V15: voltage; 1
V: voltage; 7
Vg1: voltage; 12; AC 1
Vref1: voltage; PWL(0 5 .1m 5 1.1m 5.1); AC 0
X2: NOT
Named nets: c, 0, ctrl, x, VPOS, HO3, LO3, HIN3, LIN3, VDRV, Vs, VO, VIN
.tran 0 3m 0 startup
.model MYSW SW(Ron=.01 Roff=1Meg Vt=.5 Vh=0)
.param CLOAD 20u
.param RLOAD 3
.param L 15u
.include irf520.txt
.include switching.lib
Gate driver
Pulse-width modulator
