agustin58ruiz/DISE-O_CIRCUITOS_ELECTRONICOS_1C_2022/Draft1.asc

C1: cap; 100n
M1: nmos; BSZ0904NSI
M2: nmos; BSZ0904NSI
R1: res; 10k
R2: res; 100
R3: res; 1k
RB: res; 10k
RH: res; 308k
RT: res; 10k
U1: OP07
V1: voltage; SINE(1.25V 200mV 50)
V2: voltage; 2.5V
V3: voltage; 12V
Named nets: 0, V_REF, V_F, V_CC, V_T
.tran 1
