agustin58ruiz/DISE-O_CIRCUITOS_ELECTRONICOS_1C_2022/fuente_partida.asc

C1: cap; 22µ
C2: cap; 33µ
C3: cap; 0.022µ
C4: cap; 0.01µ
D1: diode; 1N4007
D2: diode; 1N4007
R1: res; 10k
R2: res; 1k
R3: res; 1µ
U1: NE555
Named nets: 0, V-, Vin, V+
.MODEL 1N4007 D  ( IS=76.9p RS=42.0m BV=1.00k IBV=5.00u
+ CJO=26.5p  M=0.333 N=1.45 TT=4.32u )
