agustin58ruiz/DISE-O_CIRCUITOS_ELECTRONICOS_1C_2022/LDOA_with_OVLO_tran.asc

C3: cap; {CLOAD}
R17: res; R=v(VAR)
R18: res; 10
RL1: res; {RLOAD}
SEL1: voltage; PWL(500m 5 501m 0 1 0)
V1: voltage; 0
V2: voltage; -5
V3: voltage; PWL(25m 5 75m 250 250m 250 270m 0.01 350m 0.01 400m 15 475m 15 500m 5 525m 5 575m 250 750m 250 770m 0.01 850m 0.01 900m 15 975m 15 1 5)
V4: voltage; PWL(125m 5 126m 0 150m 0 175m 5 625m 5 626m 0 650m 0 675m 5)
V5: voltage; PULSE(3 0 1p 1 1p 1p)
Vref1: voltage; 1.2
VREG: voltage; PULSE(0 6.35 20m .0001 .0001 1)
X2: LDOA_with_OVLO
Named nets: 0, VREG, V-, VAR, S, E, V_OU
.param RLOAD 100k
.op
Buck
.param CLOAD 15u
.tran 0 1 0 .00005
Enable
Carga
Referencia
