agustin58ruiz/DISE-O_CIRCUITOS_ELECTRONICOS_1C_2022/OVLO UVLO.asc

M1: nmos; BSP89
M2: pmos; BSS84
M3: nmos; BSP89
M4: nmos; BSP89
M5: nmos; BSP89
M6: pmos; BSS84
R1: res; {RLOAD}
R2: res; {RLOAD}
R3: res; 250k
R4: res; {RLOAD}
RB1: res; 11.36k
RB2: res; 9.43k
RB: res; 9.43k
RH1: res; 801.28
RH: res; 801.28
RT1: res; 10k
RT2: res; 10k
RT: res; 10k
U1: lm324
U2: OP07
U3: lm324
V1: voltage; PULSE(4 6 0 2m 2m 0 0 100)
V2: voltage; 2.5
V3: voltage; 10
Named nets: 0, Vs, VoOVLO, Vt, Vop, VoUVLO
.tran 0 0.01 0
OVLO
.Step Param RLOAD 1 100 0.1
UVLO
.Param RLOAD=100
La idea es que con la tension de ovlo y uvlo se ponga
 en corto el transistor de paso para parar el paso de corriente a la carga.
Los tranistores M2 y M4 van a ser utilizados como llave.
Se pueden unificar mediante el uso de una compuerta AND.
Pienso que podemos utilizar diodos para hacer la compuerta.
Los transistores M1 y M3 se utilizan para agregar histerisis al sistema, y así 
evitar osilaciones.
Por otro lado, Vt la puse como 2.5 porque según entiendo es una tension que 
se puede armar fácilmente. Igualmente, tengo una hoja de calculo para hallar
RB y RH en función de Vt RT Vovlo y Vuvlo. 
Quizas no sea tan necesaria la histerisis, y en ese caso hay un circuito más sencillo 
de implementar, con tres resistencias, y dos opams. Lo charlamos.
