agustin58ruiz/DISE-O_CIRCUITOS_ELECTRONICOS_1C_2022/tb_GateCharge.asc

D1: schottky; 1N5817
IDRV: current; 200m
ILOAD: current; 1
R1: res; 1µ
S1: sw
U1: irf520
V1: voltage; PULSE(0 2 0 1n 1n 750n 1000n)
VBRIDGE: voltage; 12
Named nets: 0, gate, drain
.model SW SW(Ron=0.001 Roff=100Meg Vt=0.5 Vh=0.25)
.tran 0 35u 30u 100p startup
