agustin58ruiz/DISE-O_CIRCUITOS_ELECTRONICOS_1C_2022/tb_rr_charge.asc

ILOAD: current; 1
S1: sw
U1: irf520
V1: voltage; PULSE(0 2 0 100n 100n 750n 1000n)
VBRIDGE: voltage; 12
Named nets: 0, drain
.model SW SW(Ron=1u Roff=100Meg Vt=0.5 Vh=0.25)
.tran 0 35u 30u 10p startup
.meas TRAN Qrr INTEG Ix(u1:1) TRIG Ix(u1:1)=0 RISE=0 TARG Ix(u1:1)=0 FALL=0
