agustin58ruiz/DISE-O_CIRCUITOS_ELECTRONICOS_1C_2022/LDO_tran.asc

C3: cap; {CLOAD}
R17: res; R=v(VAR)
R18: res; 10
RL1: res; {RLOAD}
SEL1: voltage; PULSE(5 0 450m 0.0001 .0001 25m)
V1: voltage; 0
V2: voltage; -5
V3: voltage; PWL(200m 10 201m 10 205m 1m 206m 1m 207m 50)
V4: voltage; PULSE(5 0 .3 .001 .001 .1)
Vref1: voltage; 1.2
VREG: voltage; PULSE(0 6.35 .1 .0001 .0001 1)
X2: LDOB
Named nets: 0, VREG, V-, VAR, S, E
.param RLOAD 100
.op
Buck
.param CLOAD 15u
.tran 0 .5 0 .00005
Enable
Carga
Referencia
