agustin58ruiz/DISE-O_CIRCUITOS_ELECTRONICOS_1C_2022/LDO_compensadoI.asc

C1: cap; 10n
C2: cap; {CLOAD}
C3: cap; 1Meg
C4: cap; 10n
L2: ind; 1Meg
M1: pmos; FDC5614P
M3: nmos; 2N7000
Q1: npn; BC547C
Q2: npn; BC547C
Q3: npn; BC547C
Q4: npn; BC547C
R1: res; 11k
R2: res; 6.98k
R3: res; 11k
R4: res; 5.36k
R5: res; 100
R6: res; 10
R7: res; 121k
R8: res; 100
R9: res; 2k
R12: res; 6.98k
R19: res; {RA}
R20: res; 2.21k
R21: res; 1.82k
R28: res; 6.98k
R29: res; 121k
R30: res; 4.02k
R31: res; 6.98k
R32: res; 100k
R33: res; 100k
R34: res; 100k
R35: res; 100k
R36: res; 1k
R37: res; 1k
R38: res; 50k
R39: res; 50k
RL: res; {RLOAD}
Rs1: res; .1
SEL1: voltage; 5
U1: irf9520
U4: opamp
U6: opamp
U7: opamp
V1: voltage; 0
V3: voltage; 4.68; AC 1
Vref: voltage; 1.2
VREG: voltage; 6.3
Named nets: 0, Va, Vref, Vo, Vi, va, VREG, Vact, Vs, Vf, Vsens, Vref2
Referencia
Realimentador
a
Transistor de paso
Carga
;.step param RLOAD .01 15 .04
.model BC558B PNP(Is=1.02f Xti=3 Eg=1.11 Vaf=52.31 Bf=306.5 Ise=10.27f Ne=1.764 Ikf=91.85m Nk=.5351 Xtb=1.5 Br=6.48 Isc=1.472f Nc=1.294 Ikr=.5584 Rc=1.086 Cjc=9.81p Mjc=.332 Vjc=.4865 Fc=.5 Cje=30p Mje=.3333 Vje=.5 Tr=10n Tf=611.6p Itf=1.373 Xtf=26.05 Vtf=10 Vceo=30 Icrating=100m mfg=Philips)
.model BC548B NPN(Is=7.049f Xti=3 Eg=1.11 Vaf=62.79 Bf=374.6 Ise=68f Ne=1.576 Ikf=81.57m Nk=.4767 Xtb=1.5 Br=1 Isc=12.4f Nc=1.835 Ikr=3.924 Rc=.9747 Cjc=5.25p Mjc=.3147 Vjc=.5697 Fc=.5 Cje=11.5p Mje=.6715 Vje=.5 Tr=10n Tf=410.2p Itf=1.491 Xtf=40.06 Vtf=10 Vceo=30 Icrating=100m mfg=Philips)
.op
Buck
.inc sihf9520.lib
.model 2N7000 VDMOS(Rg=3 Vto=3 Rd=0 Rs=.75 Rb=.14 Kp=.17 mtriode=1.25 Cgdmax=80p Cgdmin=12p Cgs=50p Cjo=50p Is=.04p mfg=Fairchild Vds=60 Ron=5 Qg=.223n)
Actuador
Amplificador de Error
.ac dec 100 .1 100Meg
;.step param RLOAD 5 250 245
;.step param CLOAD 1u 15u 14u
.param CLOAD 1u
.param RLOAD .01
.step param RA 1k 1G 999.999Meg
.lib opamp.sub
Sumador
Sensado de Corriente
