agustin58ruiz/DISE-O_CIRCUITOS_ELECTRONICOS_1C_2022/tb_GateCharge_pmos.asc

D2: schottky; 1N5817
IDRV1: current; -200m
ILOAD1: current; 1
R2: res; 1µ
S2: sw
U1: irf9520
V2: voltage; PULSE(0 2 0 1n 1n 750n 1000n)
VBRIDGE1: voltage; -12
Named nets: 0, gate, drain
.model SW SW(Ron=0.001 Roff=100Meg Vt=0.5 Vh=0.25)
.tran 0 31.5u 30u 10p startup
