agustin58ruiz/DISE-O_CIRCUITOS_ELECTRONICOS_1C_2022/PCB/LDOB/LDOB.kicad_pcb

## KiCad design PCB/LDOB/LDOB.kicad_pcb (2022-06-24)

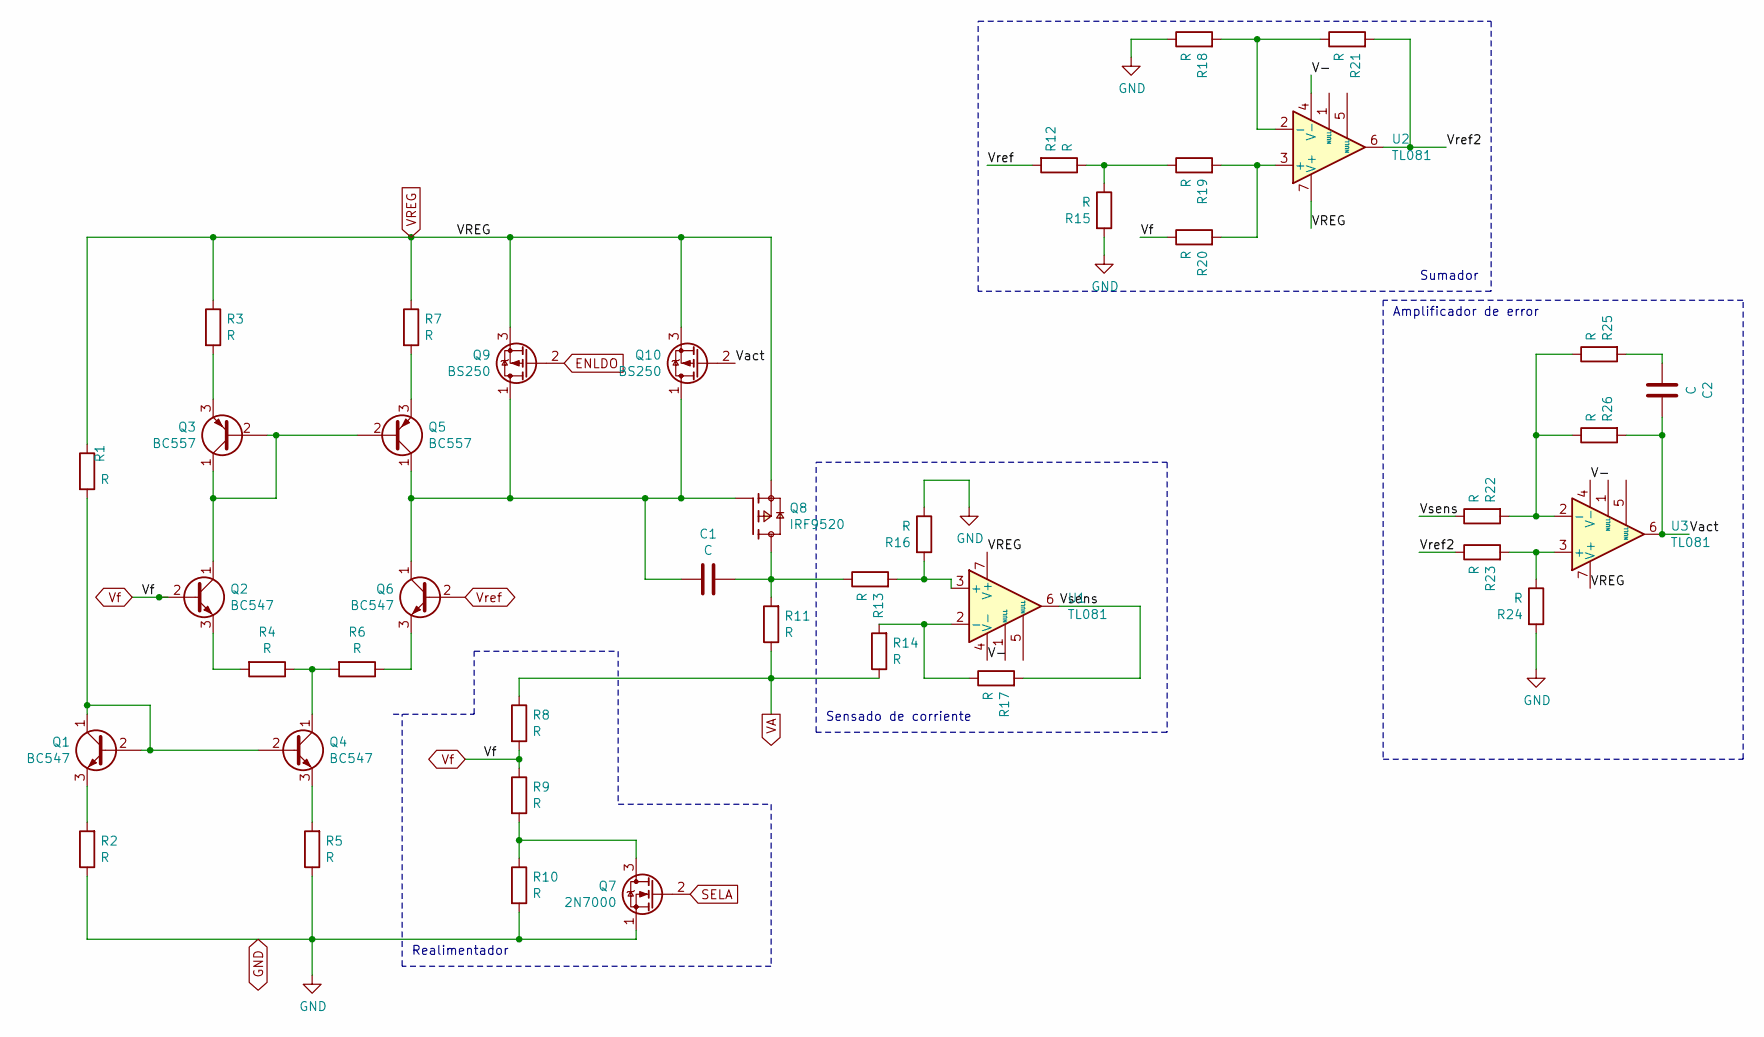
[picture p8: schematic LDOB.sch]

Parts:
C1: C; C_Disc_D5.0mm_W2.5mm_P5.00mm
C2: C; C_Disc_D4.7mm_W2.5mm_P5.00mm
Q1, Q2, Q4, Q6: BC547; TO-92_Inline
Q3, Q5: BC557; TO-92_Inline
Q7: 2N7000; TO-92_Inline
Q8: IRF9520; TO-220-3_Vertical; PARTREV B
Q9, Q10: BS250; TO-92_Inline
R1, R2, R3, R4, R5, R6, R7, R8, R9, R10, R11, R12, R13, R14, R15, R16, R17, R18, R19, R20, R21, R22, R23, R24, R25, R26: R; R_Axial_DIN0207_L6.3mm_D2.5mm_P10.16mm_Horizontal
U1, U2, U3: TL081; DIP-8_W7.62mm

Connections:
/V-: U1.4 (V-), U2.4 (V-), U3.4 (V-)
/Vact: C2.1, Q10.2 (G), R26.2, U3.6
/Vref2: R21.2, R23.1, U2.6
/Vsens: R17.2, R22.1, U1.6
ENLDO: Q9.2 (G)
GND: Q7.1 (S), R2.1, R5.1, R10.2, R15.2, R16.1, R18.1, R24.2
unnamed: C1.1, Q8.2, R11.2, R13.1
unnamed: C1.2, Q5.1 (C), Q6.1 (C), Q8.1, Q9.1 (D), Q10.1 (D)
unnamed: C2.2, R25.2
unnamed: Q1.1 (C), Q1.2 (B), Q4.2 (B), R1.2
unnamed: Q1.3 (E), R2.2
unnamed: Q2.1 (C), Q3.1 (C), Q3.2 (B), Q5.2 (B)
unnamed: Q2.3 (E), R4.2
unnamed: Q3.3 (E), R3.2
unnamed: Q4.1 (C), R4.1, R6.2
unnamed: Q4.3 (E), R5.2
unnamed: Q5.3 (E), R7.2
unnamed: Q6.3 (E), R6.1
unnamed: Q7.3 (D), R9.2, R10.1
unnamed: R12.1, R15.1, R19.1
unnamed: R13.2, R16.2, U1.3 (+)
unnamed: R14.2, R17.1, U1.2 (-)
unnamed: R18.2, R21.1, U2.2 (-)
unnamed: R19.2, R20.2, U2.3 (+)
unnamed: R22.2, R25.1, R26.1, U3.2 (-)
unnamed: R23.2, R24.1, U3.3 (+)
SELA: Q7.2 (G)
VA: R8.1, R11.1, R14.1
VREG: Q8.3, Q9.3 (S), Q10.3 (S), R1.1, R3.1, R7.1, U1.7 (V+), U2.7 (V+), U3.7 (V+)
Vf: Q2.2 (B), R8.2, R9.1, R20.1
Vref: Q6.2 (B), R12.2

Notes on the sheet:
Amplificador de error
Sumador
Sensado de corriente
Realimentador

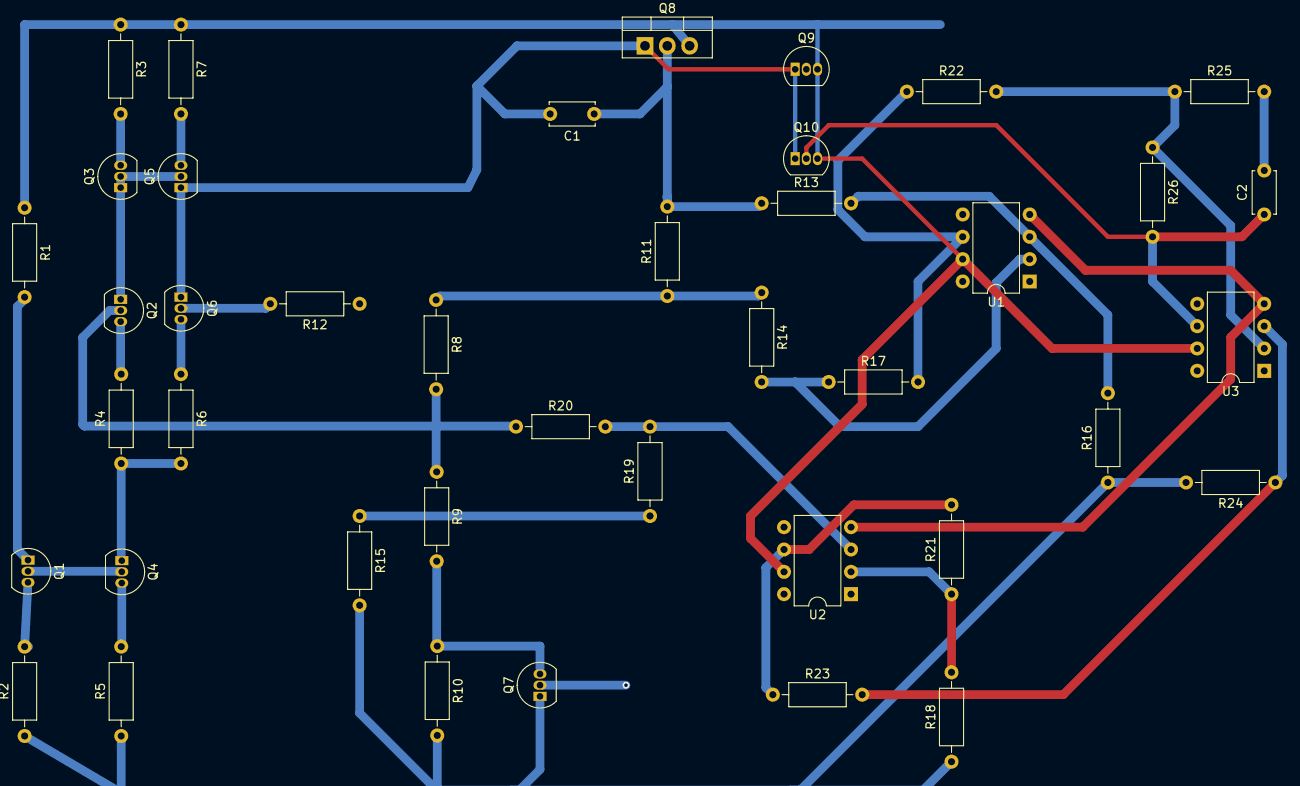
[picture p9: board LDOB.kicad_pcb from above]

Board: 2 copper layers, 41 parts (0 on the bottom side), 29 nets.
