agustin58ruiz/DISE-O_CIRCUITOS_ELECTRONICOS_1C_2022/(commit log)

2022-04-08 Nuevo esquematico: LDO en bloques para testear PMOS como transistor de paso
2022-04-13 Ordeno el esqumatico, agrego PMOS como switch en el realimentador
2022-04-17 Amplificador de error con sumidero de corriente (baja 5 veces ICQ y la ganancia se mantiene igual)
2022-04-18 Agrego archivo con modelo de irf9520
2022-04-21 Versión con transistor de salida real y foldback
2022-04-21 sumidero de corriente
2022-04-22 agrego pmos real como transistor de paso, simulaciones funcionan barbaro
2022-04-22 Cambio de lugar la R con switch del bloque realim en base a los comentarios del profe
2022-04-22 Elimino un asc que quedo re viejo
    Era el primer LDO que planteamos con transistor de paso darlington sin mucho mas que el par diferencial
2022-04-22 Elimino asc que quedo viejo - LDO con Pmos real pero sin sumidero ni foldback
2022-04-22 Correccion del bloque realim para dejar R7 invariable por el swtich
2022-04-30 Prueba de Foldback I
2022-04-30 Sensado de corriente para el Foldback (f=1)
2022-04-30 sensado de corriente para el foldback f=1
2022-05-02 Agregué el amplificador de error del foldback
2022-05-16 Se agrego el archivo OVLO UVLO
    En el archivo hay una implementación del circuito OVLO/UVLO.
2022-05-16 Hoja de calculo para OVLO UVLO
    [Calculos para UVLO OVLO.xlsx]
2022-05-18 Resistencias de valores reales y actualización al circuito.
2022-05-20 Agrego Vf al lazo de corriente y los tb para medir el pmos del Buck
    [Especificaciones.xlsx]
2022-05-21 Agrego archivo para hacer los cálculos del transistor de buck
2022-05-23 Limpié archivos y dejé el diseño final del LDOB.
2022-05-23 Edité el símbolo del LDOB
2022-05-23 Subo archivo de modelo TL081 y símbolo
2022-05-23 Subo versión de buck que no funciona bien y el archivo de cálculos corregido.
2022-05-23 Elegimos transistor para el buck
2022-05-24 Arreglamos correcciones del profesor en el buck
2022-05-26 Se agrego el OVLO UVLO en el archivo LDOA_with_OVLO*
    [Calculos para UVLO OVLO.xlsx]
2022-05-28 cambios en el archivo de calculos para OVLO UVLO
    [Calculos para UVLO OVLO.xlsx]
2022-05-28 Limpieza de archivo. Reorganizacion
2022-05-28 Reorganizacion del circuito, separacion en bloques
2022-05-30 Agregados archivos de Monte Carlo
    [Especificaciones.xlsx]
2022-05-30 Buck ideal arreglado
2022-05-30 Agrego mediciones para LDOB_mc
2022-05-30 Excel para volcar mediciones y graficar
    [Mediciones LDO.xlsx]
2022-05-31 Mediciones MC LDOB realizadas
    [Especificaciones.xlsx]
2022-05-31 LDOA_mc listo para medir mc
2022-06-01 Mediciones LDOB_mc volcadas con histogramas, desvio estandar y promedio. Lo mismo con casi todas las mediciones del LDOA_mc. Faltan mediciones OVLO 5V porque resulta dificil simular las condiciones. 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
    [Especificaciones.xlsx]
2022-06-02 Agregado modelos reales de MOSFETs
    [Especificaciones.xlsx]
2022-06-03 Mediciones UVLO MC
    [Especificaciones.xlsx]
2022-06-03 Mediciones OVLO
    [Especificaciones.xlsx]
2022-06-03 R de sangrado - OVLO
    [Especificaciones.xlsx]
2022-06-04 Ajuste resistencia histeresis OVLO
2022-06-05 WC UVLO/OVLO
    [Especificaciones.xlsx]
2022-06-05 Ovlo Uvlo WC
    [Especificaciones.xlsx]
2022-06-06 Mediciones UVLO OVLO terminadas
    [Especificaciones.xlsx]
2022-06-06 Actualizo unos ajustes al OVLO en el resto de los archivos
2022-06-07 Agregué devuelta el NOT
2022-06-10 Mediciones wc y mc LDOs terminadas
    [Especificaciones.xlsx]
2022-06-10 Calculos del DISIPADOR
    [Calculos para UVLO OVLO.xlsx, LDOA.kicad_pcb, LDOA.sch]
2022-06-11 Ajusto valores UVLO y OVLO en base a los comentarios del profe. Aumento la referencia
2022-06-11 Midiendo los 3.3V WC de vuelta para chequear resultados
    [Especificaciones.xlsx]
2022-06-11 agregado del circuito para generar diente de sierra
2022-06-12 Ajusté para Vref 1.2V
2022-06-13 Se acomodaron componentes en el PCB del circuito LDOA, También se agregó el foldback. Todavía falta sumar el UVLO OVLO, y poner los bornes para entradas y salidas del circuito.
    [LDOA.kicad_pcb, LDOA.sch]
2022-06-13 Se agregaron más componentes al PCB. Hay que seguir trabajando con la distrubicion de los componentes
    [LDOA.kicad_pcb]
2022-06-14 ajuste del diente de sierra
2022-06-14 Agrego análisis AC de buck
2022-06-15 Agregué dead timer y compensé el lazo
2022-06-16 Se agregaron mas pistas. Hay que avanzar con la inclusion del UVLO OVLO, terminales y demás
    [LDOA.kicad_pcb, LDOA.sch]
2022-06-24 agregue script para ver datos simulados en matlab
2022-06-25 adapté archivos para tomar modelos desde la carpeta del proyecto
2022-06-26 Agrego modulo de buck. Se arreglan las oscilaciones
2022-06-27 Agregue snub y control de dv/dt
2022-06-27 agrego compuertas y archivo para simular dead time
2022-06-28 acortamos el delay generado por el circuito de dead time
2022-06-28 agregué soft start y arreglé la compensación
2022-06-29 OVLO y OCP Actuan apagando el buck
2022-06-29 ajusté ovlo para actuar en 8v
2022-07-01 Se agregaron los cálculos para el inductor capacitor
2022-07-02 simulaciones hechas en buck
    [Especificaciones.xlsx]
2022-07-06 Leve ajuste estetico para screnshots
2022-07-15 creación de tb
    [Especificaciones.xlsx]
2022-07-15 agrego carpeta para entregar
2022-07-15 Agrego archivos del LDO a la carpeta para entregar
2022-07-15 imagenes de las partes del circuito
    [Calculos para UVLO OVLO.xlsx]
2025-01-02 Creo archivo para el bloque support
